cbiffle/Swamp-Thing/(commit log)

2012-08-15 Initial sketch of swamp cooler.
    [swamp-thing-revenge.scad]
2012-08-16 Cleanups in parameters and fan definition.
    [swamp-thing-revenge.scad]
2012-08-16 Added 120mm computer fan supports.
    [swamp-thing-revenge.scad]
2012-08-16 Improved pad holder assembly.
    Now has spacers that don't require levitation.
    [swamp-thing-revenge.scad]
2012-08-16 Interference adjustments to plastic parts.
    The fit between the hang panels and the reservoir was slightly off,
    and the pad assembly's spacing was slightly narrow.
    [swamp-thing-revenge.scad]
2012-08-16 Factored parts out of mock_box for easier inspection.
    [swamp-thing-revenge.scad]
2012-08-16 Noted 120mm fan option in README.
2012-08-17 Notches in front/rear panels for braces.
    This fixes issue #1.
    [swamp-thing-revenge.scad]
2012-08-20 Took corners off interior panels to allow for caulk.
    [swamp-thing-revenge.scad]
2012-08-21 Reworked brace interface to have less play.
    [swamp-thing-revenge.scad]
2012-08-21 Doubled number of crossbraces.
    Reservoir floor wasn't very rigid when made out of 1/8" acrylic.
    These crossbraces hold up the corners and help keep the frame square.
    [swamp-thing-revenge.scad]
2012-08-21 Added waist hooks to lateral panels.
    Should help fight bowing of all four walls.
    [swamp-thing-revenge.scad]
2012-08-21 Nudge pad farther back from opening.
    [swamp-thing-revenge.scad]
2012-08-21 Lid hooks to retain rear half of lid.
    [swamp-thing-revenge.scad]
